ShadowZero3000/GhostPassword/README.md

# GhostPassword
Android app that will sync with an open source hardware device for two factor authentication, encrypted password storage, and random password generation.

This is a hackathon project, so code quality may not conform to best practices, etc.
