ShadowZero3000/GhostPassword/Hardware/Case/Case.stl

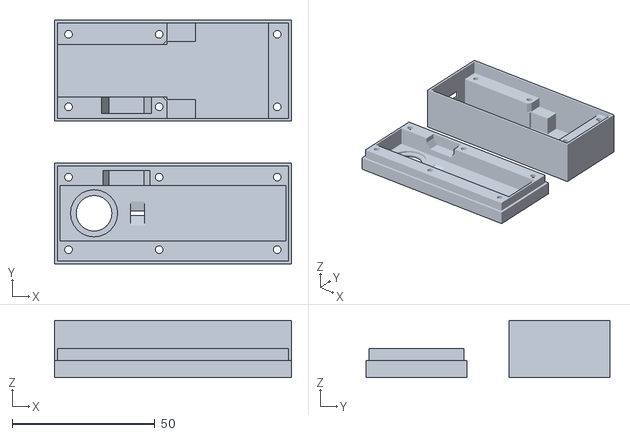
[picture p1: CAD file, 2015-11-24]
Hardware/Case/Case.stl
83.0 x 85.4 x 20.0
