ShadowZero3000/GhostPassword/Hardware/PCB/GhostPassword-LC/GhostPassword-LC.dxf

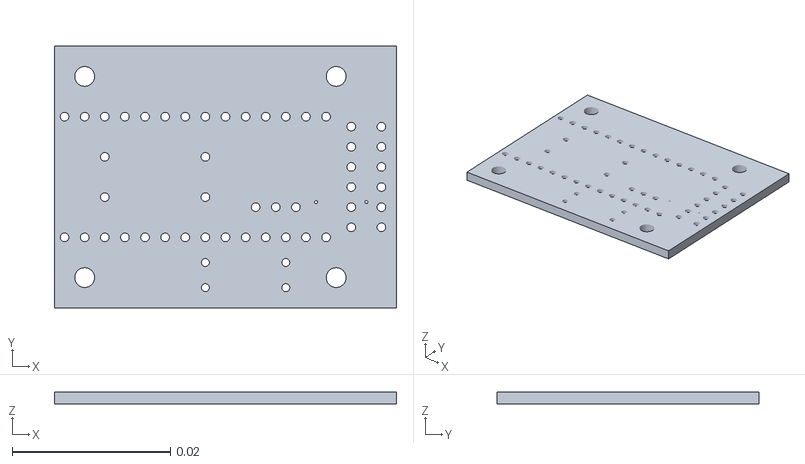
[picture p2: CAD file, 2015-11-24]
Hardware/PCB/GhostPassword-LC/GhostPassword-LC.dxf
0.0432 x 0.033 x 0.00158
