ShadowZero3000/GhostPassword/(list of files, cad)

Other CAD files:
Hardware/Case/Case with anchor holes.stl
Hardware/Case/BlueSMiRF-ChipAnt.skp
Hardware/Case/Case with anchor holes.skp
Hardware/Case/Case.skp
Hardware/Case/Teensy-3.1-all-pins.skp
Hardware/Case/Teensy-3.1-pins.skp
Hardware/Case/Teensy-3.1.skp
