ShadowZero3000/GhostPassword/Hardware/PCB/GhostPassword-LC/GhostPassword-LC.kicad_pcb

## KiCad design Hardware/PCB/GhostPassword-LC/GhostPassword-LC.kicad_pcb (2015-11-24)

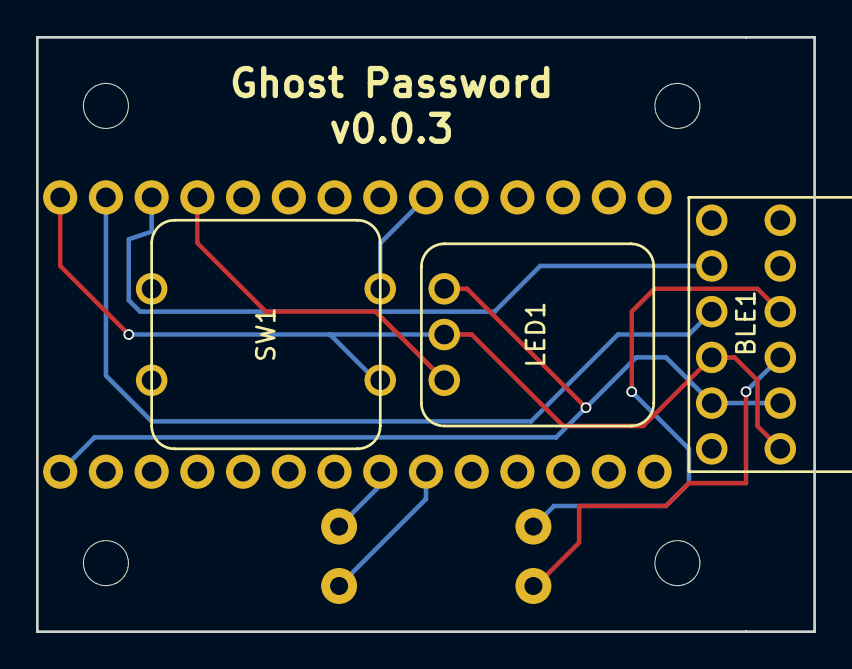
[picture p3: board GhostPassword-LC.kicad_pcb from above]

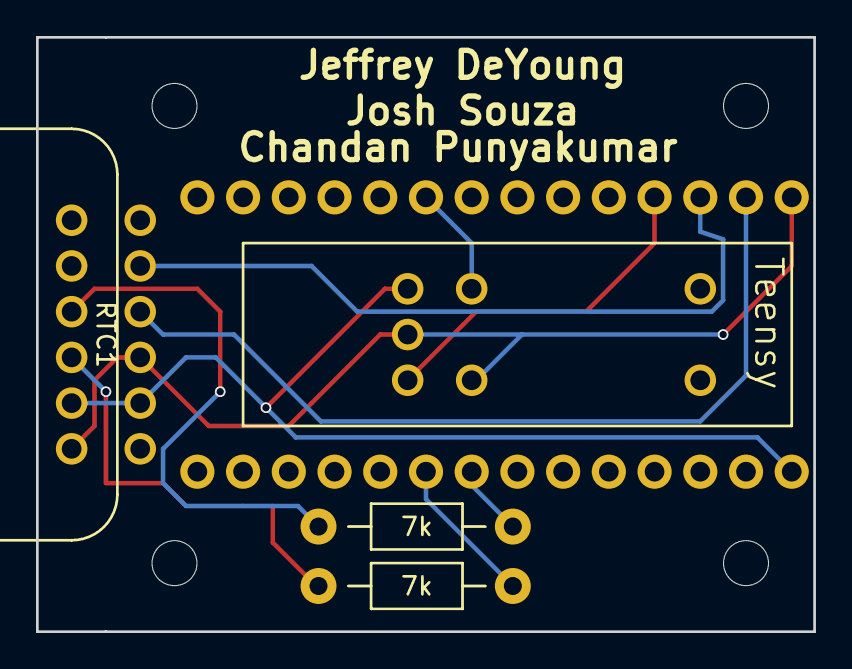
[picture p4: board GhostPassword-LC.kicad_pcb from below]

Board: 2 copper layers, 43.2 x 33.0 mm, 7 parts (4 on the bottom side), 10 nets.

Parts:
7k, 7k#2: R_Small; Resistor_Horizontal_RM10mm
BLE1: BlueSmirfHID
LED1: NeoPixel_Jewel
RTC1: DS3231
SW1: SW_PUSH; Tactile_switch
Teensy: Teensy_3.1; Teensy-3.1

Connections:
/BLE-RX-1: BLE1.5, Teensy.1
/BTN-IN: SW1.1, Teensy.7
/GND: BLE1.3, LED1.2, RTC1.1, SW1.2, Teensy.27
/LED-DIN: LED1.3, Teensy.2
/RTC-SCL: 7k.2, RTC1.4
/RTC-SDA: 7k#2.2, RTC1.3
/VCC: BLE1.2, LED1.1, RTC1.2, Teensy.26
unnamed: 7k.1, Teensy.19
unnamed: BLE1.4, Teensy.0
unnamed: 7k#2.1, Teensy.18
