ShadowZero3000/GhostPassword/backendCode_dep/GhostPasswordBackend/target/surefire-reports/com.github.ghostpassword.ghostpasswordbackend.EncryptUtilsTest.txt

-------------------------------------------------------------------------------
Test set: com.github.ghostpassword.ghostpasswordbackend.EncryptUtilsTest
-------------------------------------------------------------------------------
Tests run: 1, Failures: 0, Errors: 0, Skipped: 0, Time elapsed: 0.335 sec
