ShadowZero3000/GhostPassword/backendCode_dep/GhostPasswordBackend/target/surefire-reports/com.github.ghostpassword.ghostpasswordbackend.PasswordDaoTest.txt

-------------------------------------------------------------------------------
Test set: com.github.ghostpassword.ghostpasswordbackend.PasswordDaoTest
-------------------------------------------------------------------------------
Tests run: 2, Failures: 0, Errors: 0, Skipped: 0, Time elapsed: 0.045 sec
