ShadowZero3000/GhostPassword/(commit log)

2015-10-01 All the base work done for the Arduino
2015-10-01 more tests, more progress; not sure if they pass or not yet, commiting in case the test botches my box
2015-10-01 qr camera works
2015-10-02 Final state arduino code
2015-10-13 Let's make the LED not as bright as the sun if it starts up successfully
2015-10-14 Adjusted to enable a 'debug mode'. Nothing will ever print on the serial output unless the button is pressed down during startup. If it powers up while the button is pressed, it enters debug mode, an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
2015-11-23 Iterating arduino
2015-11-23 Got the Arduino code working right with an LC
2015-11-24 Committing initial PCB layout (v0.0.3)
    [GhostPassword-LC-B_Cu.gbl, GhostPassword-LC-B_Mask.gbs, GhostPassword-LC-B_SilkS.gbo, GhostPassword-LC-Edge_Cuts.gm1, GhostPassword-LC-F_Cu.gtl, GhostPassword-LC-F_Mask.gts, GhostPassword-LC-F_SilkS.gto, GhostPassword-LC.drl]
2015-11-24 Adding the 3d sketches for the case (SketchUp) As well as the STL files
    [BlueSMiRF-ChipAnt.skp, Case with anchor holes.skp, Case with anchor holes.stl, Case.skp, Case.stl, Teensy-3.1-all-pins.skp, Teensy-3.1-pins.skp, Teensy-3.1.skp]
2015-11-24 Gitignore to clean up the KiCad/Sketchup mess
2015-11-25 Adding colors for when BT and button actions occur
2015-11-25 Adjust delay after button presses
2017-03-10 I rebuilt the app from the ground up, and it seems to be working
    I'd like to get the OTP codes stored so you can see them in the app as well
2017-05-23 Correct time reference and delete placement
    [GhostPassword.ino]
